matoslav/FerroWave/BOM.md

# FerroWave Bill of Materials (BOM)

**Project**: FerroWave — Ferrofluid Visualizer  
**Author**: Makarov87  
**Version**: 2.1 (Manual v1 link-aligned)

> This BOM is aligned to the “LIST OF MATERIALS” pages in the User Manual v1 PDF, and includes the embedded Amazon.de links found there.

---

## 1) Essential electronics

| Item | Qty | Spec / notes | Link |
|---|---:|---|---|
| ESP32-A1S Audio Kit board (AiThinker) | 1 | ESP32-A1S “Audio Kit” board | [Amazon.de (exact)](https://www.amazon.de/-/en/ESP32-Audio-ESP32-A1S-Development-Module/dp/B0DF2W3B8K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) |
| Audio power amp | 1 | 10W module (the one used in the manual) | [Amazon.de (exact)](https://www.amazon.de/-/en/DollaTek-Amplifier-PAM8406-Digital-Immersion/dp/B07KPTNPLJ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) |
| Speakers | 2 | Speaker pair as used in the manual | [Amazon.de (exact)](https://www.amazon.de/-/en/sourcingmap-Internal-Magnet-Speaker-Loudspeaker-black/dp/B01BB4YLI0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) |
| LED ring | 1 | “24-bit LED ring (NeoPixel)” | [Amazon.de (exact)](https://www.amazon.de/-/en/dp/B09K58DMMX?ref_=ppx_hzsearch_conn_dt_b_fed_asin_title_1) |
| Electromagnet | 1 | 5V electromagnet | [Amazon.de (exact)](http://amazon.de/-/en/Electromagnet-operating-voltage-maximum-electromagnet/dp/B0D76DCRVW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) |
| Neodymium magnets | 2 | “2x neodymium magnets” | [Amazon.de (exact)](https://www.amazon.de/-/en/dp/B0CPPQ7D4Z?ref_=ppx_hzsearch_conn_dt_b_fed_asin_title_2&th=1) |
| Breadboard | 1 | Full-size solderless breadboard | [Amazon.de (exact)](https://www.amazon.de/-/en/Breadboard-Solderless-Prototype-Distribution-Connection/dp/B01MCRZFE5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) |
| Breadboard power module | 1 | MB102-style PSU module | [Amazon.de (exact)](https://www.amazon.de/Hailege-Supply-Prototype-Breadboard-6-5-12V/dp/B07XPTR9BP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) |
| Battery shield / holder | 1 | 4×18650 “Battery shield” | [Amazon.de (exact)](http://amazon.de/-/en/diymore-Shield-V9-Expansion-Compatible/dp/B082MFWC7H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) |
| 18650 Li-ion cells | 4 | Usually come included with the battery shield | — |
| MOSFET trigger / low-side switch module | 1 | This one has a flyback diode already built in | [Amazon.de (exact)](https://www.amazon.de/-/en/Mosfet-Driver-Module-MOSFET-Arduino/dp/B0DGFT4BTR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) |

---

## 2) Fluids / “other”

| Item | Qty | Notes | Link |
|---|---:|---|---|
| Ferrofluid (in a bottle) | 1 | Ready-to-use option | [Amazon.de (exact)](https://www.amazon.de/-/en/YIZITU-Ferrofluid-Tabletop-Ventilation-Decoration/dp/B0FKH35D2K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) |
| Ferrofluid (separate / concentrate) | 1 | Alternative if mixing yourself | [Amazon.de (exact)](https://www.amazon.de/-/en/Ferrofluid-Liquid-Iron-Magnetic-10/dp/B004N5ENXS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) |
| Silicone oil | 1 | Used if making ferrofluid yourself | [Amazon.de (exact)](https://www.amazon.de/Products-Silicone-Odourless-Lubricating-Plastics/dp/B072MKHDF5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) |

---

## 3) Hardware + wiring

### Screws (M3)
- M3 × 6mm: **24x**  
- M3 × 8mm: **4x**  
- M3 × 12mm: **2x**  
- M3 × 16mm: **2x**  

### Cables / jumpers
| Item | Qty | Notes | Link |
|---|---:|---|---|
| Dupont jumper wires | 1 set | Male–male, male–female, female–female | — |
| Short mini jack cable | 1 | Female–male | [Amazon.de (exact)](https://www.amazon.de/Rierousy-Waterproof-Socket-Installation-Soldering/dp/B0CSSR1H7M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) |
| Short mini jack cable | 1 | Male–male | — |
| USB cable | 1 | USB-A ↔ USB-A (or splice/join two existing cables) | — |
| Micro-USB cables | 2 | “to be cannibalized” (per manual) | — |

---

**Project**: https://github.com/matoslav/FerroWave  
**License**: MIT
