matoslav/FerroWave/(commit log)

2026-04-04 Fix docs/ path references and clarify ESP32 version requirement
2026-04-04 Fix path references and ESP32 version specificity
